chili-chip/vgc-zero-hardware/docs/modules/display.md

# Display

The screen is the [Waveshare 1.5inch RGB OLED Module](https://www.waveshare.com/wiki/1.5inch_RGB_OLED_Module): a 128 × 128 colour OLED with an SSD1351 controller. It sits on the front of the console, on a 7-pin 2.54 mm header and four standoffs.

## Specifications

| | |
|---|---|
| Panel | 1.5" OLED, 128 × 128 pixels, self-lit (no backlight) |
| Controller | [SSD1351](https://www.waveshare.com/w/upload/a/a7/SSD1351-Revision_1.5.pdf) |
| Colour depth | 262k (18-bit) in the controller; the firmware sends 65k (RGB565) |
| Interface | 4-wire SPI, write only, plus DC and RST |
| SPI clock | 20 MHz in the firmware (the SSD1351's 50 ns write cycle) |
| Full frame | 32 KB, about 13 ms on the wire at 20 MHz |
| Supply | 3.3 V |
| Module size | 44.5 × 37 mm |
| Mounting | 7-pin header, four 2 mm holes |

## Pinout

The header pins are numbered as on the Waveshare module.

| Pin | Module label | Net | RP2350 GPIO |
|---|---|---|---|
| 1 | VCC | 3V3 | |
| 2 | GND | GND | |
| 3 | DIN | `DISP_DIN` | GP27 (SPI1 TX) |
| 4 | CLK | `DISP_CLK` | GP26 (SPI1 SCK) |
| 5 | CS | `DISP_CS` | GP28 |
| 6 | DC | `DISP_DC` | GP22 |
| 7 | RST | `DISP_RST` | GP21 |

The panel has no TE (tearing effect) pin on this module, so the firmware cannot sync to the panel's refresh.

## Brightness

An OLED has no backlight. Brightness is the SSD1351's contrast setting, which the firmware sets over SPI. Black pixels are off and draw no power, so dark games use less battery.

## History

| Board | How the display was connected |
|---|---|
| Breadboard prototype | 1.44" ST7735S TFT |
| v1.1.4 | Waveshare 1.5" OLED on a 7-pin JST cable |
| v2.0.0 and later | Same module, on a 2.54 mm pin header ([#21](https://github.com/chili-chip/vgc-zero-hardware/issues/21)) |

A switch to a TFT IPS panel was looked at and dropped. A cheaper bare SSD1351 panel is planned only for a future fully assembled board ([chilichip-console-hardware #16](https://github.com/chili-chip/chilichip-console-hardware/issues/16)).

## Footprints

| Footprint | Use |
|---|---|
| `SSD1351_OLED_128x128_WAVESHARE` | The Waveshare module (44.5 × 37 mm). Used on v3.0.0 |
| `SSD1351_OLED_128x128` | Generic 128 × 128 SSD1351 modules |

## Links

| | |
|---|---|
| Product wiki | [Waveshare 1.5inch RGB OLED Module](https://www.waveshare.com/wiki/1.5inch_RGB_OLED_Module) |
| Firmware driver | [Display driver](https://sdk.chilichip.eu/console/display/) in the SDK docs |
| 3D model | `3d-models/1_5inch-rgb-oled-module_asm-1110.stp` |
