chili-chip/vgc-zero-hardware/docs/images/modules/buttons-top.png

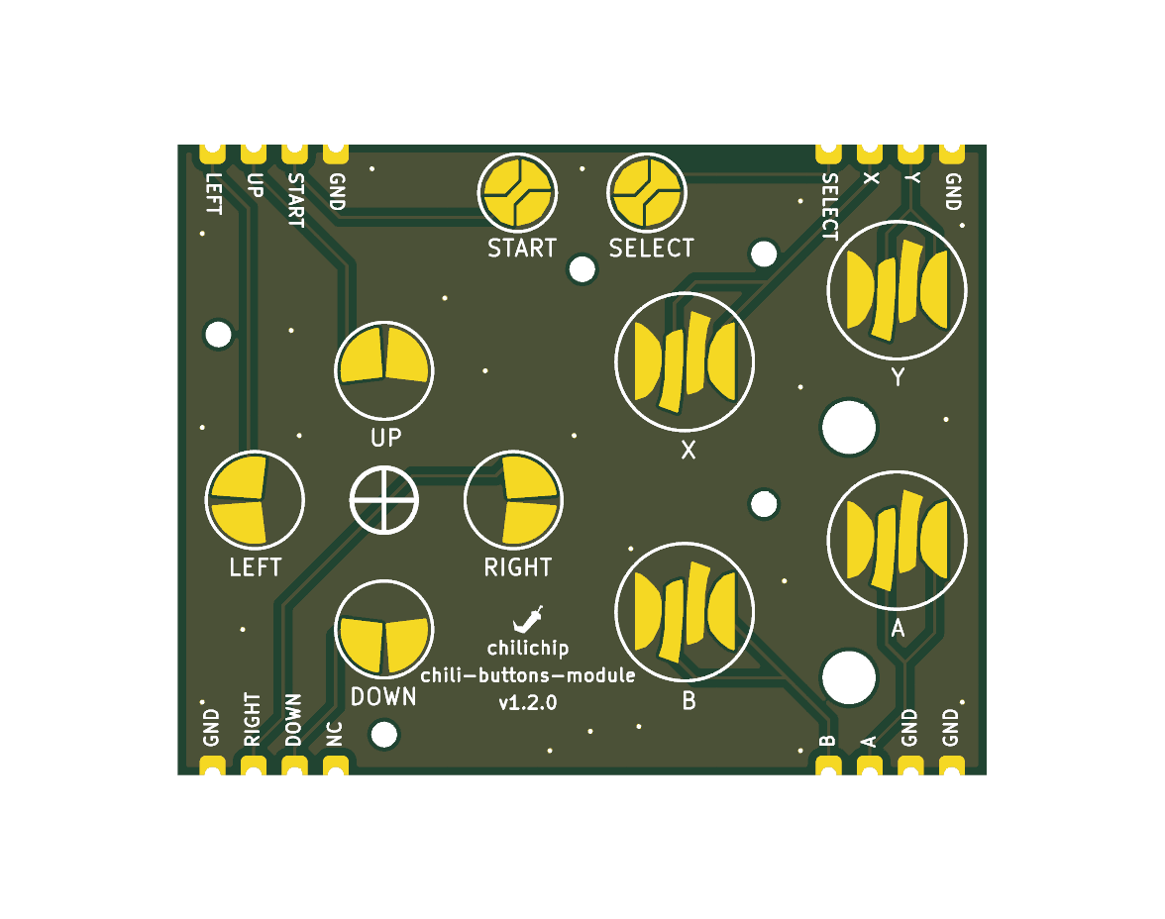
docs/images/modules/buttons-top.png
