chili-chip/vgc-zero-hardware/3d-models/chili-utility-module-hardware.step

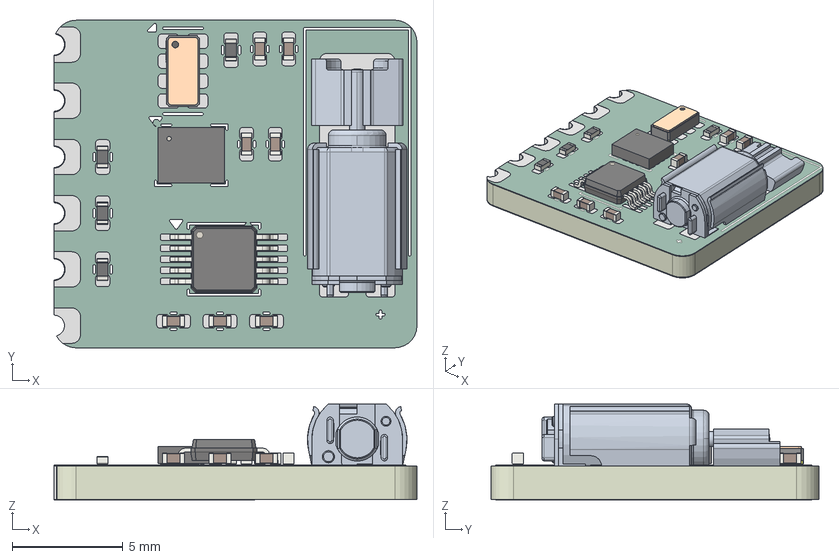
[picture p9: CAD file, 2026-11-06]
3d-models/chili-utility-module-hardware.step
16.4 x 14.8 x 4.38 mm
SHAFT
PRT0004_1
VARISTOR
WASHER
PRT0004
CP-M_3
CP-M_8
CP-M_1
CP-M_6
CP-M_1_1
CP-M_4
CP-M_10
CP-M
CP-M_9
CP-M_2
CP-M_5
CP-M_12
CP-M_11
CP-M_7
CP-M_1_2
CP-T
COMSLIAO
TAOHUAN
COMTONGP_2
COMTONGP_1
COMTONGP
ZHI_JIA
CASE
METAL_C
MAGNET
MAGNET_1
COUNTER_WEIGHT
BRUSH_SHUATI
BRUSH_CASE
BRUSH_BOARD
BRUSH_CASE-1
BRUSH_SHUATI-1
METAL_E
C_0402_1005Metric x 7
R_0402_1005Metric x 4
LGA_14_3x25mm_P05mm_LayoutBorder3x4y
OSC-SMD_8P-L3.2-W1.5-P0.90-BL
TSSOP-10_3x3mm_P0.5mm
chili-utility-module_copper
chili-utility-module_pad
chili-utility-module_via
chili-utility-module_silkscreen x 2
chili-utility-module_soldermask x 2
chili-utility-module_PCB
