chili-chip/vgc-zero-hardware/3d-models/chili-buttons-module-hardware.step

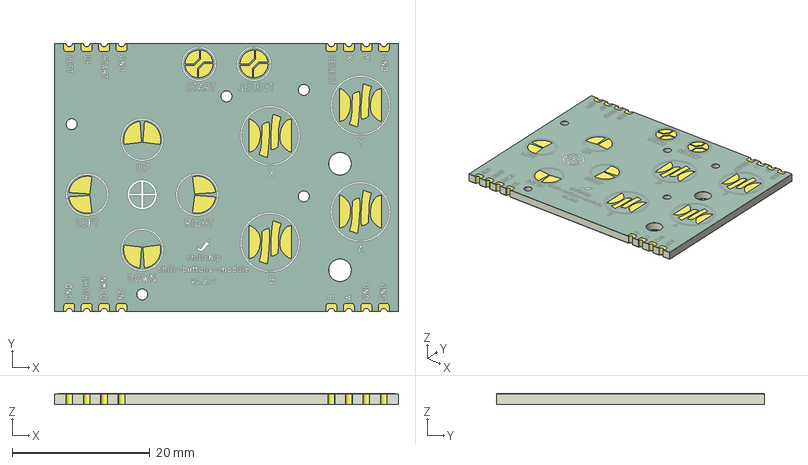
[picture p10: CAD file, 2026-11-05]
3d-models/chili-buttons-module-hardware.step
50.0 x 39.0 x 1.64 mm
chili-buttons-module-hardware_copper
chili-buttons-module-hardware_pad
chili-buttons-module-hardware_via
chili-buttons-module-hardware_silkscreen
chili-buttons-module-hardware_soldermask x 2
chili-buttons-module-hardware_PCB
