chili-chip/vgc-zero-hardware/vgc-zero.kicad_pcb

## KiCad design vgc-zero.kicad_pcb (2026-11-06)

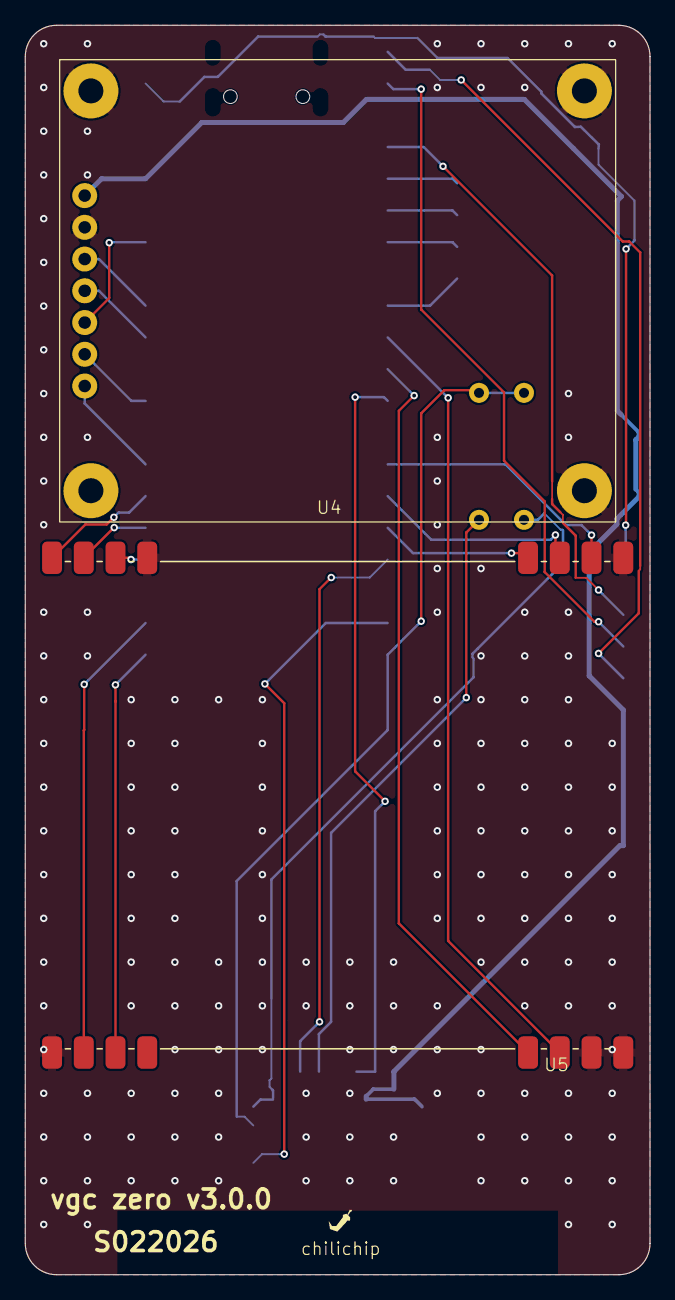
[picture p13: board vgc-zero.kicad_pcb from above]

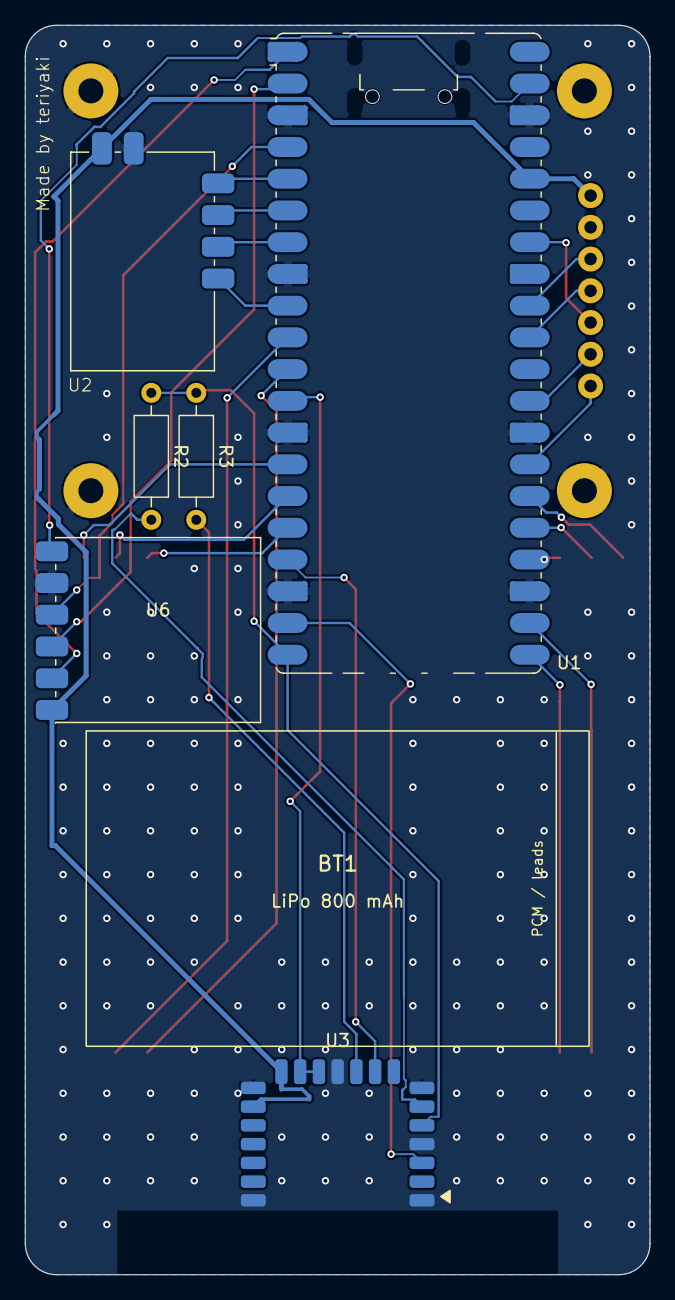
[picture p14: board vgc-zero.kicad_pcb from below]

Board: 2 copper layers, 50.0 x 100.0 mm, 9 parts (7 on the bottom side), 31 nets.

Parts:
BT1: LP802540 800mAh; LiPo_LP802540
R2: 470; R_Axial_DIN0207_L6.3mm_D2.5mm_P10.16mm_Horizontal
R3: 10k; R_Axial_DIN0207_L6.3mm_D2.5mm_P10.16mm_Horizontal
U1: RP2350-Plus
U2: AUDIO_MODULE; AudioModule
U3: RADIO_MODULE; RMC20452T
U4: DISPLAY_MODULE; SSD1351_OLED_128x128_WAVESHARE
U5: BUTTONS_MODULE; ButtonsModule
U6: UTILITY_MODULE; UtilityModule

Connections:
+3.3V: U1.36, U2.1 (3V3), U3.14 (VDDIO), U3.16 (VIN), U4.1 (VCC), U6.1
/AUDIO_BCLK: U1.6, U2.4 (BCLK)
/AUDIO_DIN: U1.5, U2.3 (DIN)
/AUDIO_LRCLK: U1.7, U2.5 (LRCLK)
/AUDIO_MODE: U1.9, U2.6 (MODE)
/BTN_A: U1.10, U5.14 (A)
/BTN_B: U1.11, U5.13 (B)
/BTN_DOWN: U1.21, U5.10 (DOWN)
/BTN_LEFT: U1.26, U5.1 (LEFT)
/BTN_RIGHT: U1.22, U5.11 (RIGHT)
/BTN_SELECT: U1.16, U5.5 (SELECT)
/BTN_START: U1.24, U5.3 (START)
/BTN_UP: U1.25, U5.2 (UP)
/BTN_X: U1.15, U5.6 (X)
/BTN_Y: U1.14, U5.7 (Y)
/DISP_CLK: U1.31, U4.4 (CLK)
/DISP_CS: U1.34, U4.5 (CS)
/DISP_DC: U1.29, U4.6 (DC)
/DISP_DIN: U1.32, U4.3 (DIN)
/DISP_RST: U1.27, U4.7 (RST)
/UTIL_INT: U1.4, U6.4
/UTIL_SCL: U1.2, U6.3
/UTIL_SDA: U1.1, U6.2
/VSYS: U1.39, U6.6
/WIFI_CLK: U1.19, U3.3 (SCLK)
/WIFI_CS: U1.17, U3.9 (CS)
/WIFI_DIO: R2.1, R3.1, U1.20, U3.5 (DI)
/WIFI_ON: U1.12, U3.12 (WL_ON), U3.13 (BT_ON)
GND: U1.3, U1.8, U1.13, U1.18, U1.23, U1.28, U1.38, U2.2 (GND), U3.1 (GND), U3.4 (GND), U3.7 (GND), U3.11 (GND), U3.15 (GND), U3.21 (GND), U4.2 (GND), U5.4 (GND), U5.8 (GND), U5.12 (GND), U5.15 (GND), U5.16 (GND), U6.5
unnamed: R2.2, U3.6 (DO)
unnamed: R3.2, U3.10 (nIRQ)
