chili-chip/vgc-zero-hardware/(commit log)

2025-12-10 Create pcb design
    [vgc-zero.kicad_pcb, vgc-zero.kicad_sch]
2025-12-10 move symbols to project library
    [vgc-zero.kicad_sch]
2025-12-10 pcb done
    [vgc-zero.kicad_pcb, vgc-zero.kicad_sch]
2025-12-11 move via off the pad
    [vgc-zero.kicad_pcb]
2025-12-11 Add GitHub Actions workflow for KiCad 9 CI
2025-12-11 Refactor output paths in GitHub Actions workflow
    Updated output directory paths for schematic and gerbers.
2025-12-11 Add release job for uploading KiCad artifacts
    Added a new job to upload KiCad artifacts to GitHub releases when a release is published.
2025-12-11 Package Gerbers as zip and tar.gz
    Added steps to package Gerbers into zip and tar.gz formats before creating a GitHub release.
2025-12-11 add markings
    [vgc-zero.kicad_pcb, vgc-zero.kicad_sch]
2025-12-11 final touches
    [vgc-zero.kicad_pcb]
2025-12-11 bump all the way to 1.0.0
    [vgc-zero.kicad_pcb, vgc-zero.kicad_sch]
2025-12-11 minor fixes
    [vgc-zero.kicad_pcb, vgc-zero.kicad_sch]
2026-03-02 update to 1.1.0
    [vgc-zero.kicad_pcb, vgc-zero.kicad_sch]
2026-03-03 adjust display pins
    [vgc-zero.kicad_pcb, vgc-zero.kicad_sch]
2026-03-03 bump version
    [vgc-zero.kicad_pcb, vgc-zero.kicad_sch]
2026-03-05 major improvements
    [vgc-zero.kicad_pcb, vgc-zero.kicad_sch]
2026-03-06 minor improvements
    [vgc-zero.kicad_pcb, vgc-zero.kicad_sch]
2026-03-06 fix overlap
    [vgc-zero.kicad_pcb, vgc-zero.kicad_sch]
2026-10-11 Bump the github-actions group with 5 updates
    Bumps the github-actions group with 5 updates:
    | Package | From | To |
    | --- | --- | --- |
    | [actions/checkout](https://github.com/actions/checkout) | `4` | `7` |
    | [actions-for-kicad/kicad-actions](https://github.com/actions-for-kicad/kicad-actions) | `1.6.pre.k9.0` | `9.0.4` |
    | [actions/upload-artifact](https://github.com/actions/upload-artifact) | `4` | `7` |
    | [actions/download-artifact](https://github.com/actions/download-artifact) | `4` | `8` |
    | [softprops/action-gh-release](https://github.com/softprops/action-gh-release) | `2` | `3` |
    Updates `actions/checkout` from 4 to 7
    - [Release notes](https://github.com/actions/checkout/releases)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
2026-10-11 CI: go back to kicad-actions v1.6-k9.0 (#16)
    The Dependabot bump to v1.6-k9.0.4 (#15) runs a newer KiCad whose DRC
    reports 5 violations on the unchanged board, so the workflow is red.
    Pin the previous version until the violations are reviewed.
    Claude-Session: https://claude.ai/code/session_01LB5UHwRUCafjcYbnumUZJt
2026-10-15 Add README with board v1.1.4 parts list and pin map (#18)
2026-10-22 Revert "Merge pull request #27 from chili-chip/claude/project-thread-j6h5np"
    This reverts commit f5e35fb097c880f44c5f99a4973178b91f79b36c, reversing
    changes made to bcb7947237a867739d3c22dc75c0c2951d9176b0.
2026-10-25 ci: run KiCad 10 in CI (files are now saved by KiCad 10.0)
    Since 99630fe ('add radio module') the schematic and PCB are saved by
    KiCad 10.0. The KiCad 9 image cannot read them ('Failed to load
    schematic'), so master CI is red. KiCad is not forwards compatible:
    https://docs.kicad.org/10.0/en/introduction/introduction.html
    Supersedes Dependabot #22 (KiCad 9.0.4).
    Claude-Session: https://claude.ai/code/session_01NchwRUXJFWe5CAwHNzx5gz
2026-11-04 Document next revision plan and move CI to KiCad 10 (#26)
    * Document next revision plan: OLED on header, audio module, RM2 WiFi
    Claude-Session: https://claude.ai/code/session_01La4EjyELbRhCWCUejKv1pv
    * CI: move to KiCad 10 (kicad-actions v2.7-k10.0.7)
    The board files are now saved by KiCad 10, which the KiCad 9 action
    cannot load ("Failed to load schematic").
    Claude-Session: https://claude.ai/code/session_01La4EjyELbRhCWCUejKv1pv
    * CI: print the ERC and DRC reports in the job log
    Cl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
2026-11-04 button module
2026-11-05 v2.0.0: castellated modules, GPIO map, routed board, project polish (#34)
    * v2.0.0: castellated modules, GPIO map, routed board, project polish
    Board and schematic
    - Pico 2 (SMD, castellated) on the back; audio module, RM2 and R2/R3 on
    the back; display and buttons module on the front.
    - AudioModule/ButtonsModule symbols, footprints and 3D models updated for
    the castellated module revisions: SMD lands at the castellations, module
    models seated flat. Fixes the AudioModule pad order (DIN/BCLK/LRCLK/MODE
    were reversed against the module). ButtonsModule pin 9 is now NC.
    - GPIOs reassigned so each trace runs short and straight to its module;
    display on SPI1 (GP26 SCK, GP27 TX), Wi-Fi o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
2026-11-06 v3.0.0: RP2350-Plus, flush LiPo, 50 x 100 mm board, utility module on board (#35)
    * Utility module (U6) on the schematic: I2C on GP0/GP1, INT on GP2
    * v3.0.0: RP2350-Plus, flush LiPo, 50 x 100 mm board, utility module on board
    - MCU: Waveshare RP2350-Plus replaces the Pico 2. New RP2350-Plus symbol
    (Pico pinout without the SWD pads), footprint (Pico hand-solder lands plus
    NPTH clearance for the USB-C shell legs and pegs under the module) and
    Waveshare's STEP model (gzipped .stpZ). 3V3 track moved off the new holes.
    - Battery: LP802540 LiPo (8.0 x 25 x 40 mm, ~800 mAh, PCM) flat on the back
    between the MCU and the RM2, plugged into the RP2350-Plus's PH1.25 header.
    Schematic symbol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
2026-11-06 Exclude the accepted display silkscreen DRC warning (#36)
    CI fails since v3.0.0 (#35). kicad-actions runs DRC with
    --exit-code-violations, so the one silk_edge_clearance warning
    (U4 display outline crosses a U1 USB-C leg hole) fails the
    kicad-ci job and skips the artifact uploads.
    The warning was accepted in #35 because the fab clips silkscreen
    at holes. Record it as a DRC exclusion in the project so CI stays
    strict for anything new.
2026-11-13 Add MkDocs documentation site for the console and its modules (#40)
    Specifications, architecture, pin map, power, mechanical, parts list,
    build guide and firmware notes for main board v3.0.0, plus one page per
    module (brain, display, buttons, audio, utility, radio), revisions and a
    contributor guide. Renders, placement drawings and schematic SVGs from
    KiCad 10. render-images.sh now also exports the drawings and schematic.
    Deploys to Cloudflare Pages (hardware.chilichip.eu) from master.
